Certaingemstone/OpenQuantum/teaching/mit-spring-2024/experiment/talbot-wavemeter/CAD/GratingSensorMount.FCStd

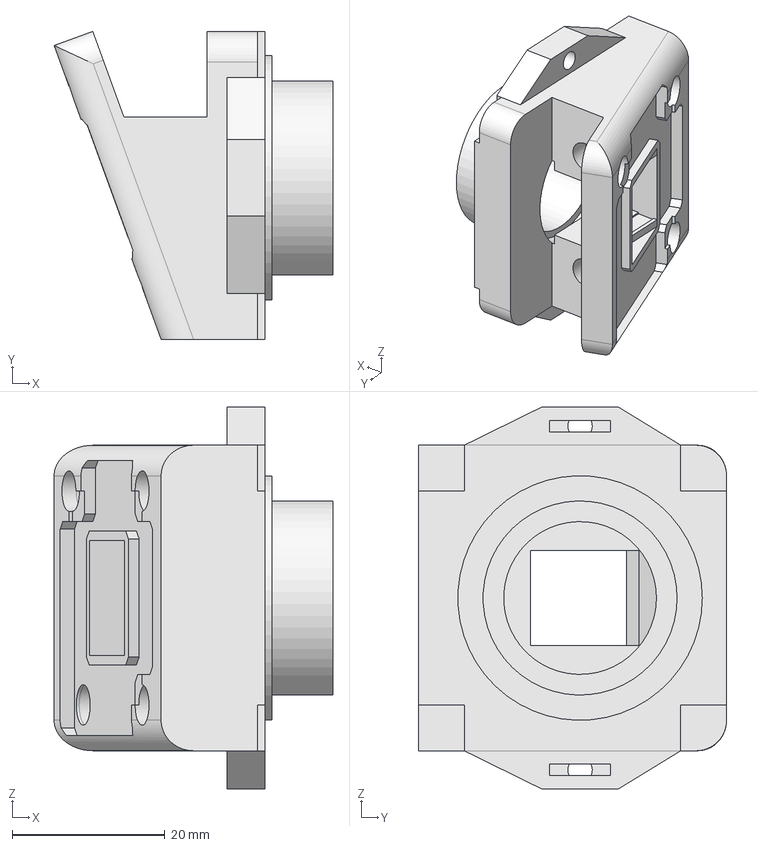
[picture p1: CAD file, 2024-05-11]
teaching/mit-spring-2024/experiment/talbot-wavemeter/CAD/GratingSensorMount.FCStd
36.5 x 40.3 x 50.0 mm
