Certaingemstone/OpenQuantum/teaching/mit-spring-2024/experiment/talbot-wavemeter/CAD/TubeClamp.FCStd

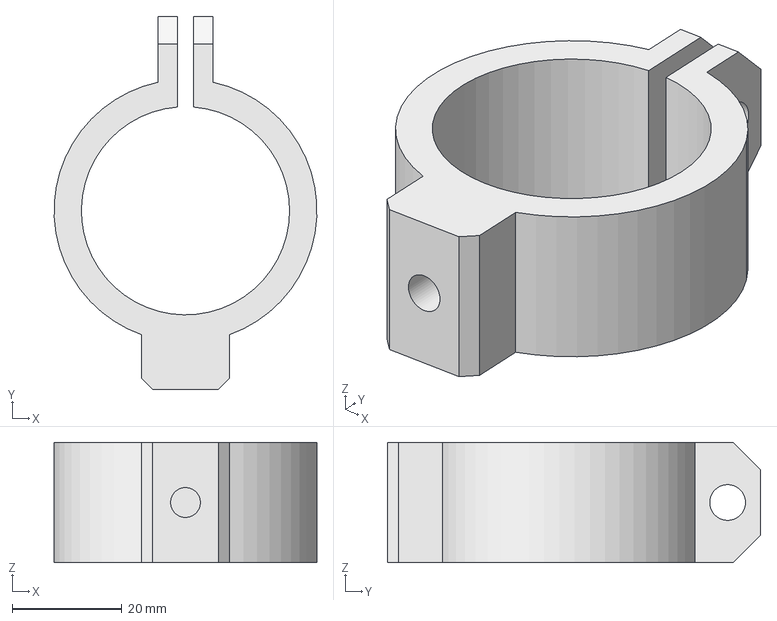
[picture p2: CAD file, 2024-05-11]
teaching/mit-spring-2024/experiment/talbot-wavemeter/CAD/TubeClamp.FCStd
47.9 x 68.1 x 22.0 mm
