Certaingemstone/OpenQuantum/teaching/mit-spring-2024/experiment/talbot-wavemeter/CAD/GratingSensorMount-Clamp_v1.stl

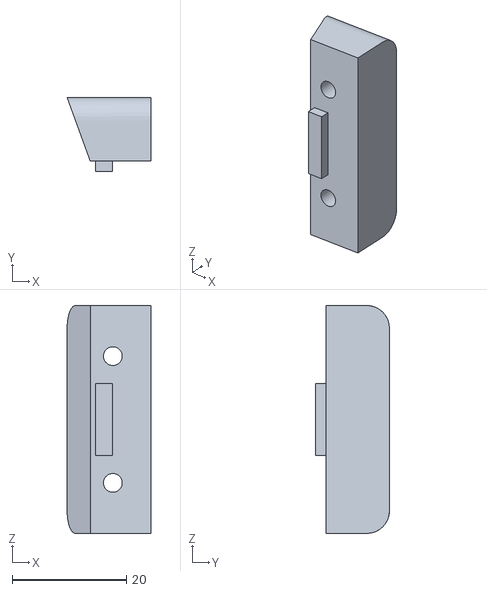
[picture p3: CAD file, 2024-04-29]
teaching/mit-spring-2024/experiment/talbot-wavemeter/CAD/GratingSensorMount-Clamp_v1.stl
14.7 x 13.0 x 40.0
