Certaingemstone/OpenQuantum/teaching/mit-spring-2024/experiment/talbot-wavemeter/CAD/GratingSensorMount-Body_v1.stl

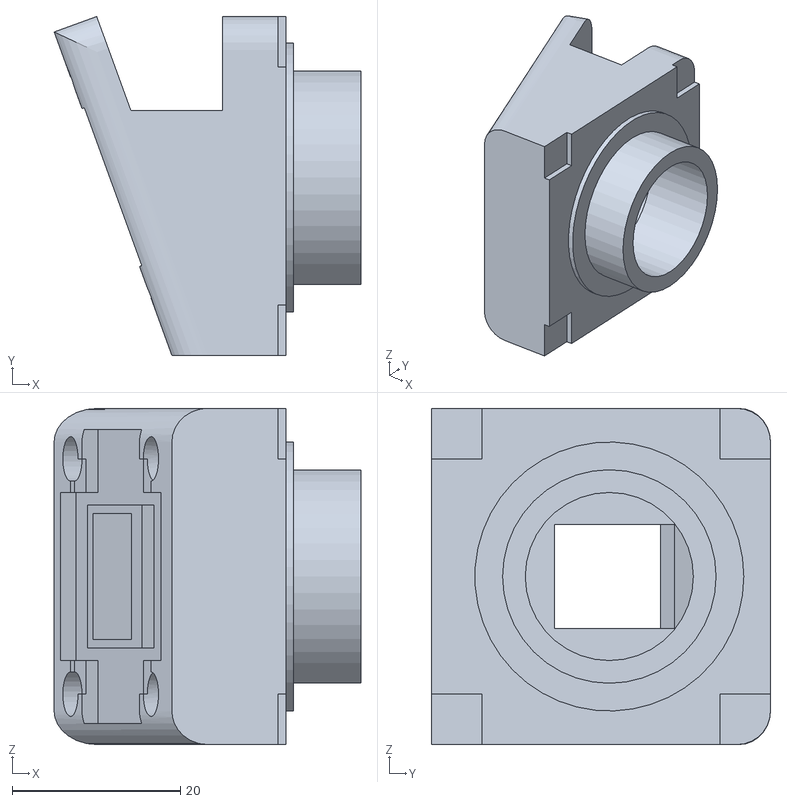
[picture p4: CAD file, 2024-04-29, an earlier design]
teaching/mit-spring-2024/experiment/talbot-wavemeter/CAD/GratingSensorMount-Body_v1.stl
36.5 x 40.3 x 40.0
