Certaingemstone/OpenQuantum/(list of files, cad)

Other CAD files:
teaching/mit-spring-2024/experiment/talbot-wavemeter/CAD/GratingSensorMount-Body_v2.stl
teaching/mit-spring-2024/experiment/talbot-wavemeter/CAD/TubeClamp-Body.stl
teaching/mit-spring-2024/experiment/talbot-wavemeter/CAD/GratingClamp.FCStd
