Certaingemstone/OpenQuantum/(commit log)

2024-04-29 Add current CAD files
    [ColumbiaWavemeterv21.step, GT25-08-Step.step, GratingClamp.FCStd, GratingSensorMount-Body_v1.stl, GratingSensorMount-Clamp_v1.stl, GratingSensorMount.FCStd]
2024-04-29 Add current code
2024-05-13 Remove non-Talbot stuff, add report
    [1 4-20 Bolt_39509fe4_v1.step, 1 4-20 Bolt_39509fe4_v1.stl, 4-40 Bolt_v1.step, 4-40 Bolt_v1.stl, 8-32 Bolt_v1.step, 8-32 Bolt_v1.stl, 92196A539_18-8 Stainless Steel Socket Head Screw_v1.step, 92196A539_18-8 Stainless Steel Socket Head Screw_v1.stl]
